HeyPCB/esp32-s3-devkit/fab/esp32-s3-devkit-bom.csv

Comment | Designator | Footprint | LCSC Part #
100nF | C1,C6,C7 | C_0603_1608Metric | C14663
10uF | C2,C3,C4,C5,C11,C12 | C_0805_2012Metric | C15850
100nF | C8,C9,C10 | C_0402_1005Metric | C1525
WS2812B | D1,D2,D3 | LED_WS2812B_PLCC4_5.0x5.0mm_P3.2mm | C2761795
1N5819W | D4 | D_SOD-123 | C369937
USB-C | J1 | USB_C_Receptacle_HRO_TYPE-C-31-M-12 | C165948
Left | J2 | PinHeader_1x18_P2.54mm_Vertical | C2894941
Right | J3 | PinHeader_1x18_P2.54mm_Vertical | C2894941
10k | R1,R4,R5 | R_0603_1608Metric | C25804
5.1k | R2,R3 | R_0402_1005Metric | C25905
330 | R6 | R_0402_1005Metric | C25104
BOOT | SW1 | SW_SPST_TL3305A | C2886902
RST | SW2 | SW_SPST_TL3305A | C2886902
ESP32-S3-WROOM-1-N8R8 | U1 | ESP32-S3-WROOM-1 | C2913201
AMS1117-3.3 | U2 | SOT-223-3_TabPin2 | C6186
USBLC6-2SC6 | U3 | SOT95P280X145-6N | C2827654
