HeyPCB/esp32-s3-devkit/esp32-s3-devkit.kicad_pcb

## KiCad design esp32-s3-devkit.kicad_pcb (2026-10-16)

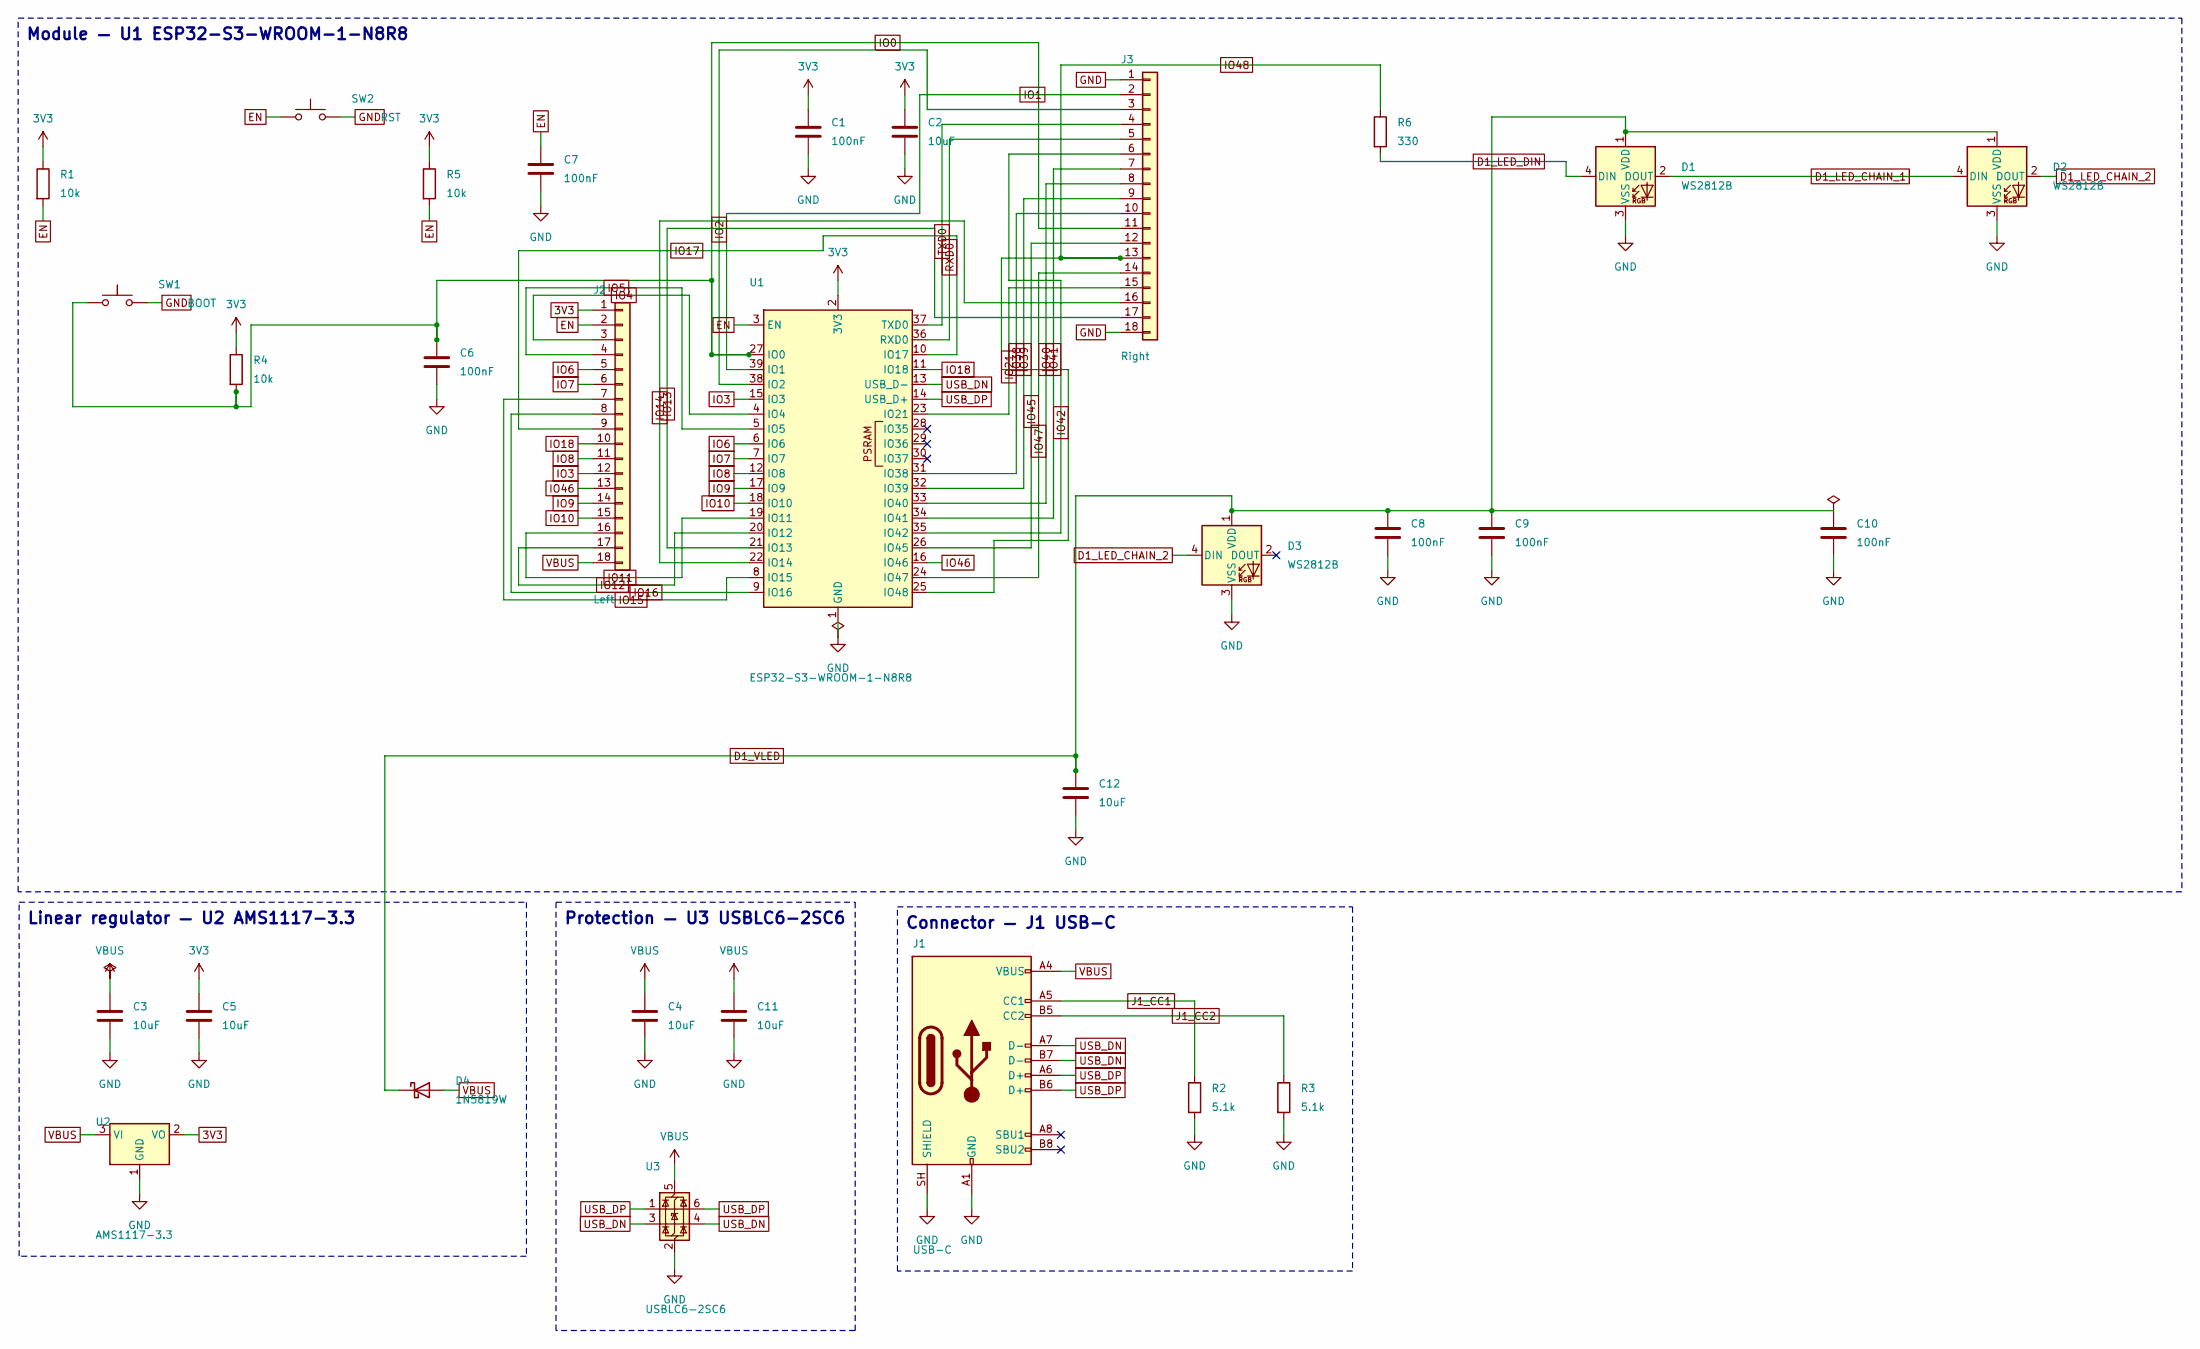
[picture p3: schematic esp32-s3-devkit.kicad_sch, ESP32-S3 DevKit]

Parts:
C1, C6, C7: 100nF; C_0603_1608Metric
C2, C3, C4, C5, C11, C12: 10uF; C_0805_2012Metric
C8, C9, C10: 100nF; C_0402_1005Metric
D1, D2, D3: WS2812B; LED_WS2812B_PLCC4_5.0x5.0mm_P3.2mm
D4: 1N5819W; D_SOD-123
J1: USB-C; USB_C_Receptacle_HRO_TYPE-C-31-M-12
J2: Left; PinHeader_1x18_P2.54mm_Vertical
J3: Right; PinHeader_1x18_P2.54mm_Vertical
R1, R4, R5: 10k; R_0603_1608Metric
R2, R3: 5.1k; R_0402_1005Metric
R6: 330; R_0402_1005Metric
SW1: BOOT; SW_SPST_TL3305A
SW2: RST; SW_SPST_TL3305A
U1: ESP32-S3-WROOM-1-N8R8; ESP32-S3-WROOM-1
U2: AMS1117-3.3; SOT-223-3_TabPin2
U3: USBLC6-2SC6; SOT95P280X145-6N

Connections:
3V3: C1.1, C2.1, C5.1, J2.1, R1.1, R4.1, R5.1, U1.2 (3V3), U2.2 (VO)
D1_LED_CHAIN_1: D1.2 (DOUT), D2.4 (DIN)
D1_LED_CHAIN_2: D2.2 (DOUT), D3.4 (DIN)
D1_LED_DIN: D1.4 (DIN), R6.2
D1_VLED: C8.1, C9.1, C10.1, C12.1, D1.1 (VDD), D2.1 (VDD), D3.1 (VDD), D4.1 (K)
EN: C7.1, J2.2, R1.2, R5.2, SW2.1, U1.3 (EN)
GND: C1.2, C2.2, C3.2, C4.2, C5.2, C6.2, C7.2, C8.2, C9.2, C10.2, C11.2, C12.2, D1.3 (VSS), D2.3 (VSS), D3.3 (VSS), J1.A1 (GND), J1.A12 (GND), J1.B1 (GND), J1.B12 (GND), J1.SH (SHIELD), J3.1, J3.18, R2.2, R3.2, SW1.2, SW2.2, U1.1 (GND), U1.40 (GND), U1.41 (GND), U2.1 (GND), U3.2 (GND)
IO0: C6.1, J3.11, R4.2, SW1.1, U1.27 (IO0)
IO1: J3.2, U1.39 (IO1)
IO2: J3.3, U1.38 (IO2)
IO3: J2.12, U1.15 (IO3)
IO4: J2.3, U1.4 (IO4)
IO5: J2.4, U1.5 (IO5)
IO6: J2.5, U1.6 (IO6)
IO7: J2.6, U1.7 (IO7)
IO8: J2.11, U1.12 (IO8)
IO9: J2.14, U1.17 (IO9)
IO10: J2.15, U1.18 (IO10)
IO11: J2.16, U1.19 (IO11)
IO12: J2.17, U1.20 (IO12)
IO13: J3.17, U1.21 (IO13)
IO14: J3.16, U1.22 (IO14)
IO15: J2.7, U1.8 (IO15)
IO16: J2.8, U1.9 (IO16)
IO17: J2.9, U1.10 (IO17)
IO18: J2.10, U1.11 (IO18)
IO21: J3.15, U1.23 (IO21)
IO38: J3.10, U1.31 (IO38)
IO39: J3.9, U1.32 (IO39)
IO40: J3.8, U1.33 (IO40)
IO41: J3.7, U1.34 (IO41)
IO42: J3.6, U1.35 (IO42)
IO45: J3.12, U1.26 (IO45)
IO46: J2.13, U1.16 (IO46)
IO47: J3.14, U1.24 (IO47)
IO48: J3.13, R6.1, U1.25 (IO48)
J1_CC1: J1.A5 (CC1), R2.1
J1_CC2: J1.B5 (CC2), R3.1
RXD0: J3.5, U1.36 (RXD0)
TXD0: J3.4, U1.37 (TXD0)
USB_DN: J1.A7 (D-), J1.B7 (D-), U1.13 (USB_D-), U3.3 (I/O2), U3.4 (I/O2)
USB_DP: J1.A6 (D+), J1.B6 (D+), U1.14 (USB_D+), U3.1 (I/O1), U3.6 (I/O1)
VBUS: C3.1, C4.1, C11.1, D4.2 (A), J1.A4 (VBUS), J1.A9 (VBUS), J1.B4 (VBUS), J1.B9 (VBUS), J2.18, U2.3 (VI), U3.5 (VBUS)

Notes on the sheet:
Module — U1 ESP32-S3-WROOM-1-N8R8
Linear regulator — U2 AMS1117-3.3
Protection — U3 USBLC6-2SC6
Connector — J1 USB-C

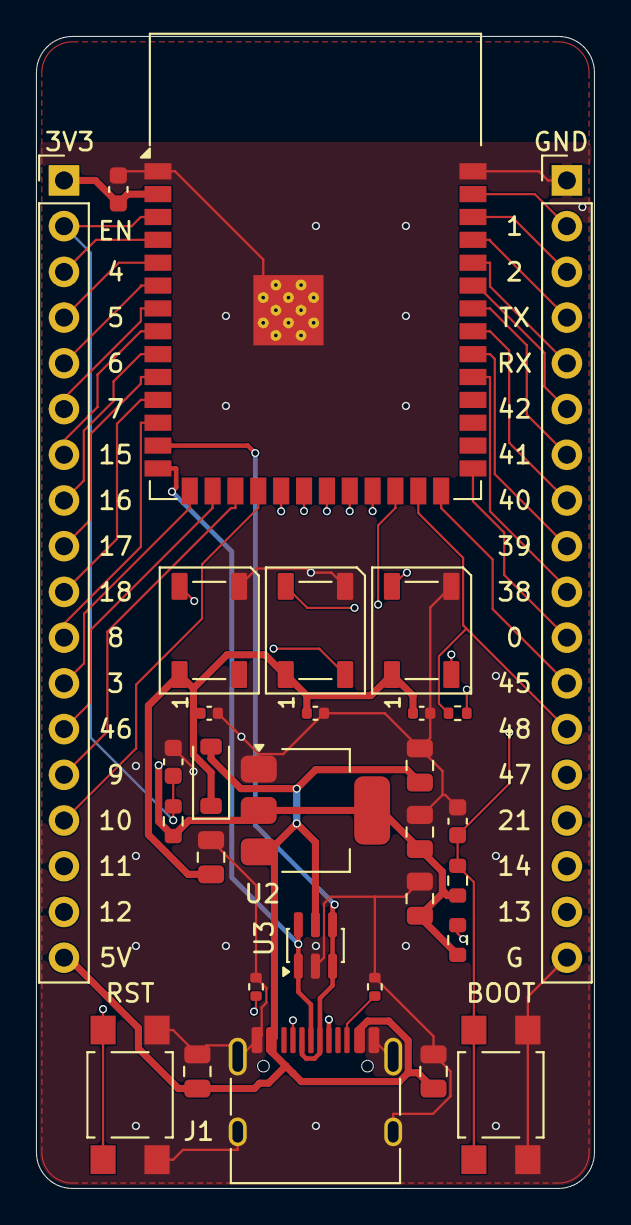
[picture p4: board esp32-s3-devkit.kicad_pcb from above]

Board: 4 copper layers, 31.0 x 64.0 mm, 30 parts (0 on the bottom side), 43 nets.
