HeyPCB/esp32-s3-devkit/(commit log)

2026-10-16 ESP32-S3 DevKit: KiCad project, fab files and renders
    A 31 x 64 mm, 4-layer ESP32-S3-WROOM-1 board in the DevKitC-1 layout,
    built through HeyPCB's MCP server. DRC 0 errors (HeyPCB and KiCad 10.0.6),
    ERC 0, fab-ready for JLCPCB. Known warnings, including the 1.45 mm USB
    skew, are listed in the README.
    [esp32-s3-devkit-bom.csv, esp32-s3-devkit.kicad_pcb, esp32-s3-devkit.kicad_sch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]
2026-10-16 README: link the Circuit World listing
